ClouD-161803/TurboCAD_CourseWorkModule/Notes/Turbo CAD Part3A TT24.pdf

SW24 NOTES

BDF_TT23 SW2024NOTES

Turbomachinery CAD CWM PART 3A

RADIAL FLOW WATER TURBINE

Exercise 2 - Design, Manufacture and Testing of a Runner for Given Operating Point Conditions

Runner Performance

This part of the exercise is concerned with the testing of the runner over a range of flow rates through the turbine. Here, a series of measurements will be taken for varied settings of applied load at a target head and guide vane opening. The performance will be assessed in terms of power efficiency η versus flow rate Q. If a successful design has been achieved, the resulting curve should peak at the design operating point condition Q. Note that 1 bar = 10kPa.

MEASURED QUANTITIES

H ....... FLUID ENERGY HEAD | (bar)
Q ....... FLUID FLOW RATE | (litres/sec)
N ....... RUNNER SPEED | (revs/min)
T ....... ALTERNATOR TORQUE | (Nm)

Power Out

Po = T x ω = T x N/60 x 2π = 0.10472 x T x N (W)

Power In

Pi = ρgQH = 1000 x 9.81 x Q x 10⁻³ x H x 10.19

= 100 x Q x H (W)

Efficiency | η = Po/Pi

SW24 NOTES

BDF_TT23 SW2024NOTES

NAME: | COLLEGE: | DATE:
DESIGN ANGLES: | β1 = | β2 =

OPERATING POINT:

H = 0.7 bar | Q = 2.0 l/s | N = 1300 rpm | αo = 9.8°

Θo = Guide Vane Indicator Angle ≈ 63%

Use Matlab to Plot efficiency η against volumetric flow Q for the points recorded, along with a best fit curve. Note the value of Q for maximum η. Include a title, a grid, and axes labels and units.
Include the graph and suitable comments in your report.
(Q)η max = | (η)max = _____________
