ClouD-161803/TurboCAD_CourseWorkModule/CAD/Final Assembly/TC000.SLDASM

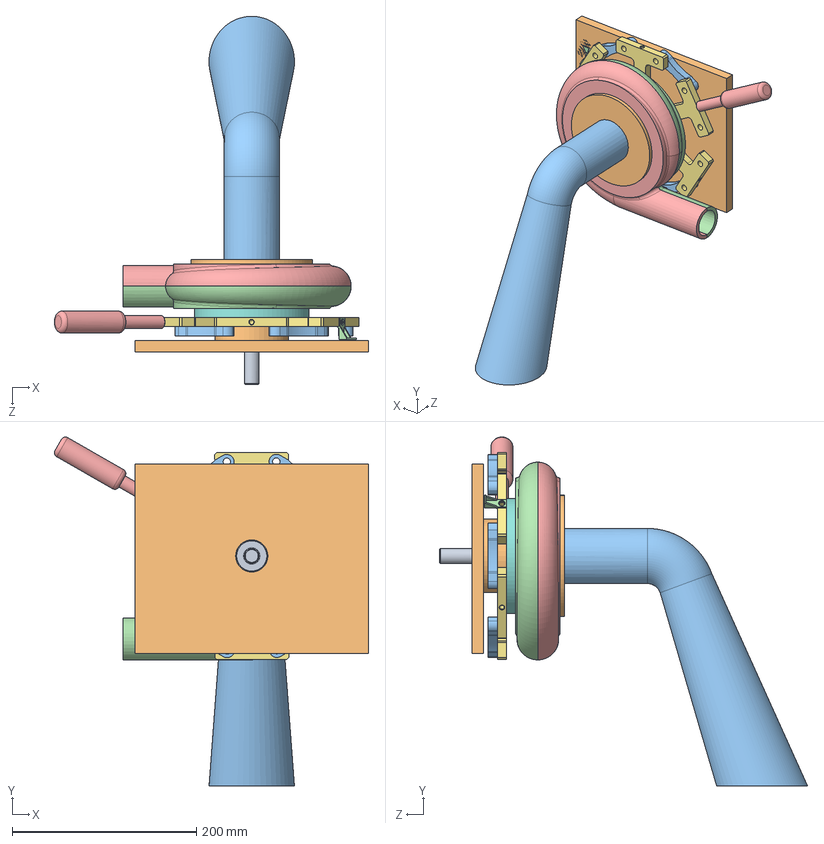
[picture p87: CAD file, 2024-10-17]
CAD/Final Assembly/TC000.SLDASM
341.5 x 379.3 x 400.3 mm
VC001
VC002
DT002
SP001
Runner_107.6
GV006
GV001 x 6
GV005 x 6
GV002
GV004
modified link x 5
MP001
DS001
