ClouD-161803/TurboCAD_CourseWorkModule/CAD/Francis Turbine/Modified assembly/GV000 no links.SLDASM

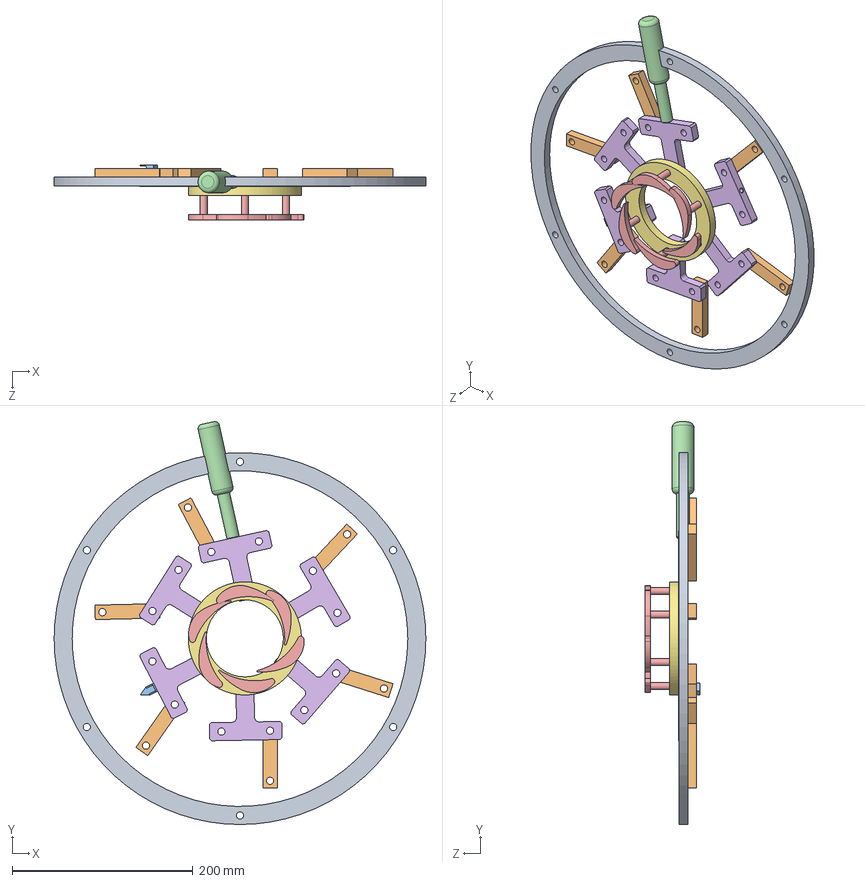
[picture p88: CAD file, 2024-10-17]
CAD/Francis Turbine/Modified assembly/GV000 no links.SLDASM
410.8 x 445.3 x 61.3 mm
GV006
GV001 x 6
GV005 x 6
GV002
GV004
GV003 x 6
gigaring
