ClouD-161803/TurboCAD_CourseWorkModule/CAD/Francis Turbine/Modified assembly/GV000.SLDASM

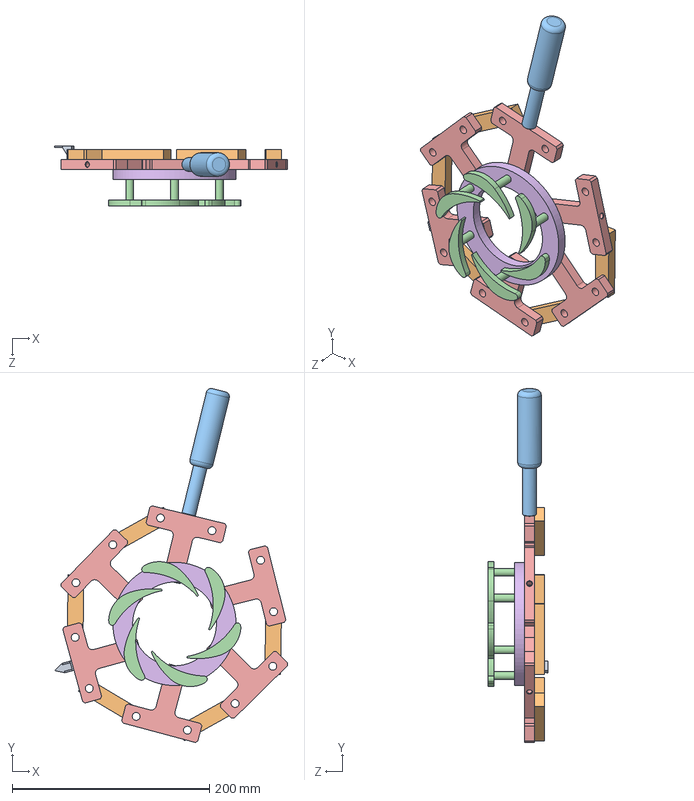
[picture p89: CAD file, 2024-10-17]
CAD/Francis Turbine/Modified assembly/GV000.SLDASM
236.5 x 359.2 x 61.3 mm
GV006
GV001 x 6
GV005 x 6
GV002
GV003 x 5
GV004
