ClouD-161803/TurboCAD_CourseWorkModule/CAD/Francis Turbine/Easy approach/Assembly/GV Sub Assembly.SLDASM

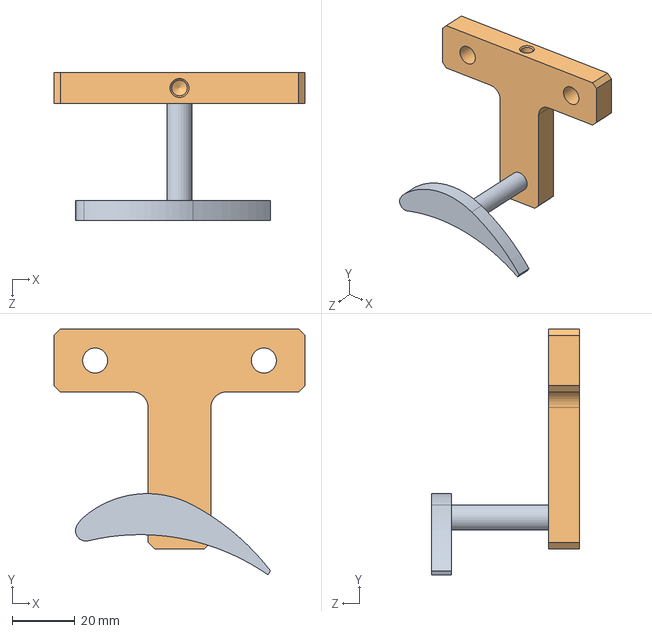
[picture p90: CAD file, 2024-10-17]
CAD/Francis Turbine/Easy approach/Assembly/GV Sub Assembly.SLDASM
80.0 x 78.3 x 47.3 mm
GV001
GV005
