ClouD-161803/TurboCAD_CourseWorkModule/CAD/Francis Turbine/Easy approach/Assembly/GV000 Final.SLDASM

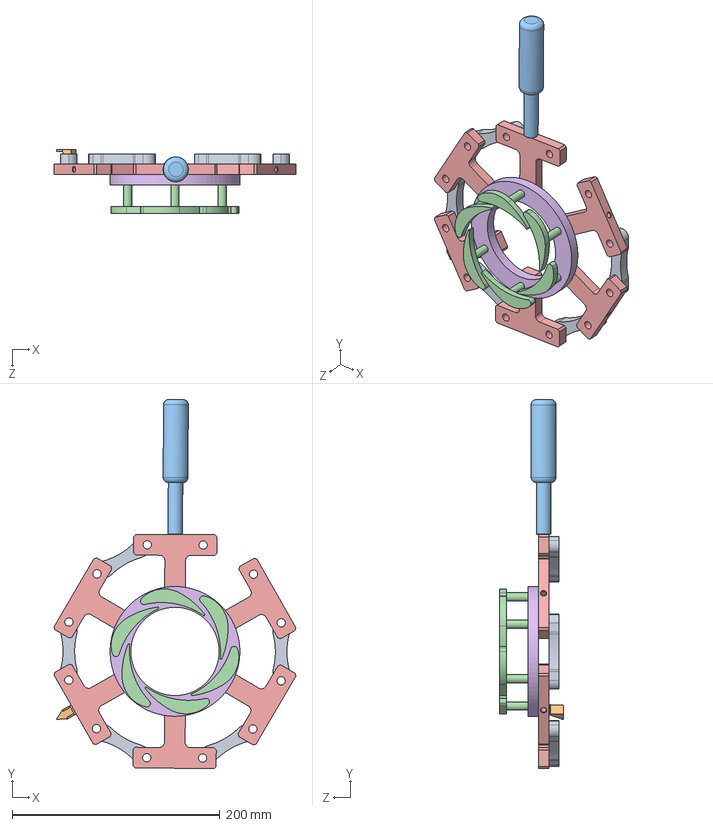
[picture p91: CAD file, 2024-10-17]
CAD/Francis Turbine/Easy approach/Assembly/GV000 Final.SLDASM
232.9 x 355.3 x 61.3 mm
GV006
GV001 x 6
GV005 x 6
GV002
GV004
modified link x 5
