ClouD-161803/TurboCAD_CourseWorkModule/CAD/Francis Turbine/Default  Assembly/GV000.SLDASM

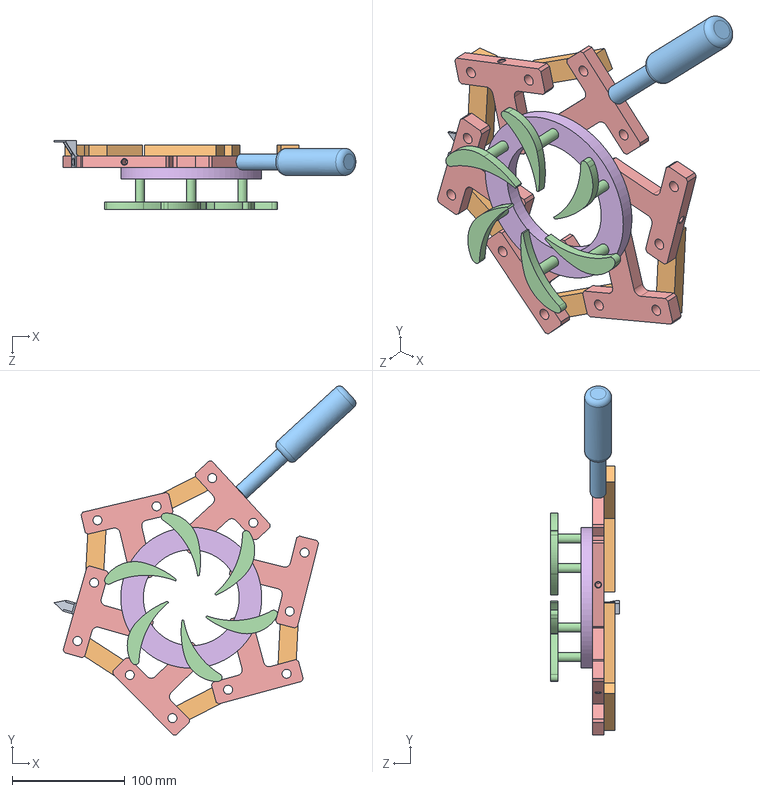
[picture p92: CAD file, 2024-10-17]
CAD/Francis Turbine/Default Assembly/GV000.SLDASM
267.6 x 309.5 x 61.3 mm
GV006
GV001 x 6
GV005 x 6
GV002
GV003 x 5
GV004
