ClouD-161803/TurboCAD_CourseWorkModule/CAD/Francis Turbine/Default  Assembly/GV001.SLDPRT

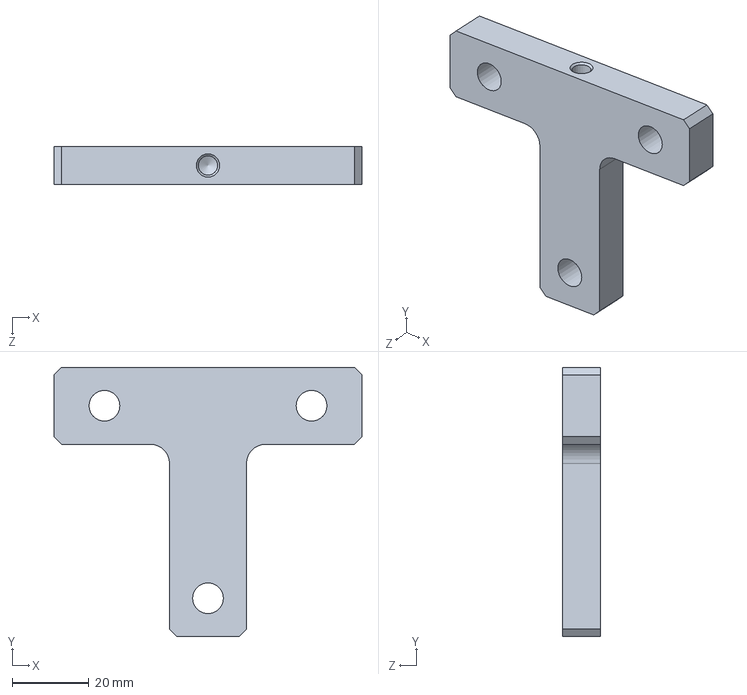
[picture p93: CAD file, 2024-10-17]
CAD/Francis Turbine/Default Assembly/GV001.SLDPRT
80.0 x 70.0 x 10.0 mm
