ClouD-161803/TurboCAD_CourseWorkModule/CAD/Francis Turbine/Easy approach/Assembly/GV002.SLDPRT

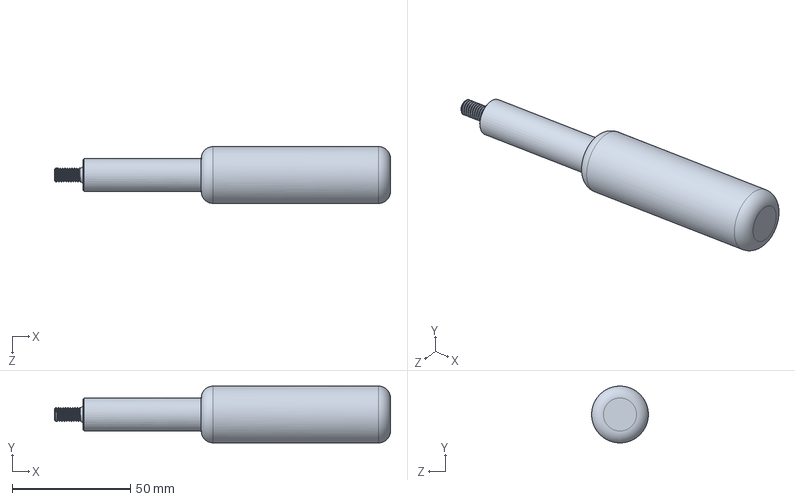
[picture p94: CAD file, 2024-10-17]
CAD/Francis Turbine/Easy approach/Assembly/GV002.SLDPRT
142.0 x 24.0 x 24.0 mm
