ClouD-161803/TurboCAD_CourseWorkModule/CAD/Impeller/Final/MP001.SLDPRT

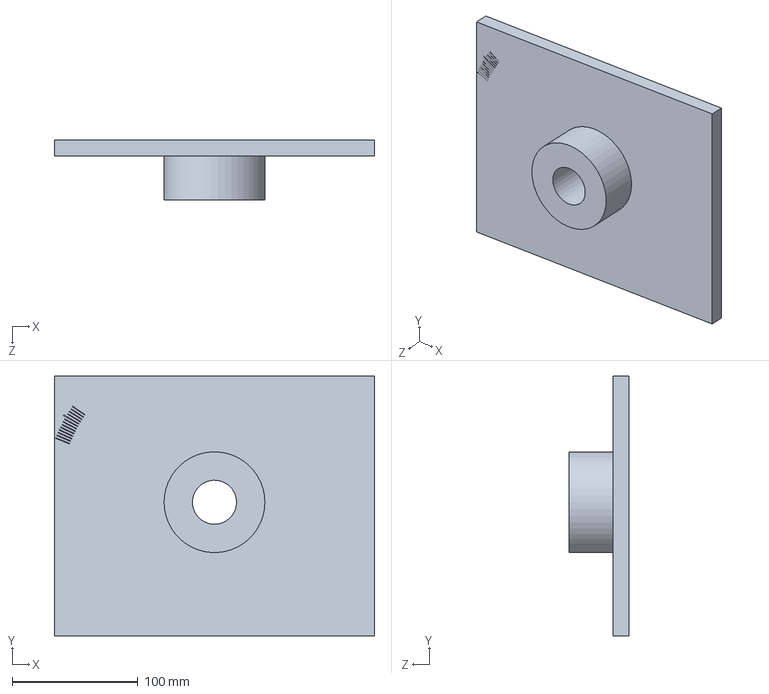
[picture p95: CAD file, 2024-10-17]
CAD/Impeller/Final/MP001.SLDPRT
254.0 x 206.0 x 47.7 mm
