ClouD-161803/TurboCAD_CourseWorkModule/CAD/Impeller/VC001 Wrong.SLDPRT

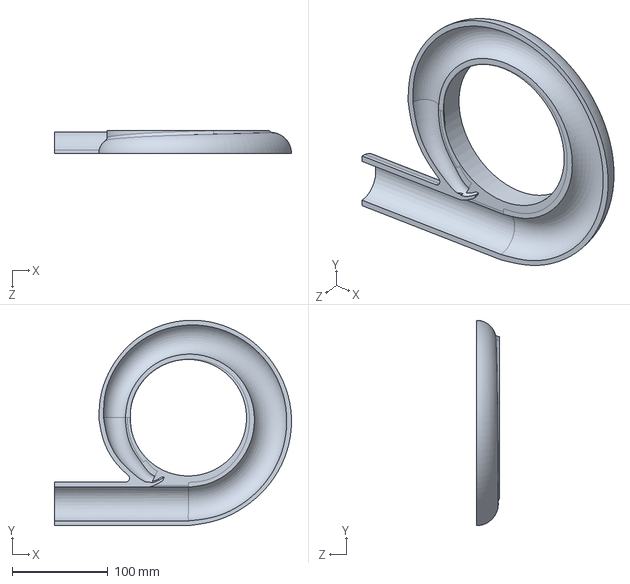
[picture p96: CAD file, 2024-10-17]
CAD/Impeller/VC001 Wrong.SLDPRT
248.0 x 214.9 x 24.0 mm
