ClouD-161803/TurboCAD_CourseWorkModule/CAD/Francis Turbine/Default  Assembly/GV004.SLDPRT

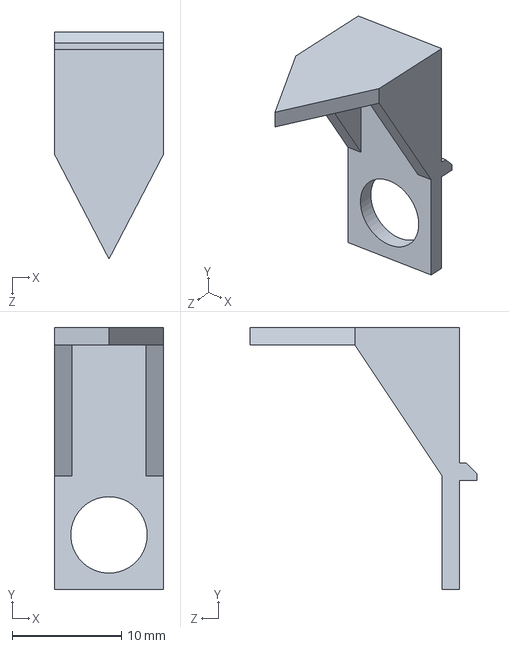
[picture p97: CAD file, 2024-10-17]
CAD/Francis Turbine/Default Assembly/GV004.SLDPRT
10.0 x 24.0 x 20.8 mm
