ClouD-161803/TurboCAD_CourseWorkModule/CAD/Francis Turbine/Easy approach/Assembly/GV003.SLDPRT

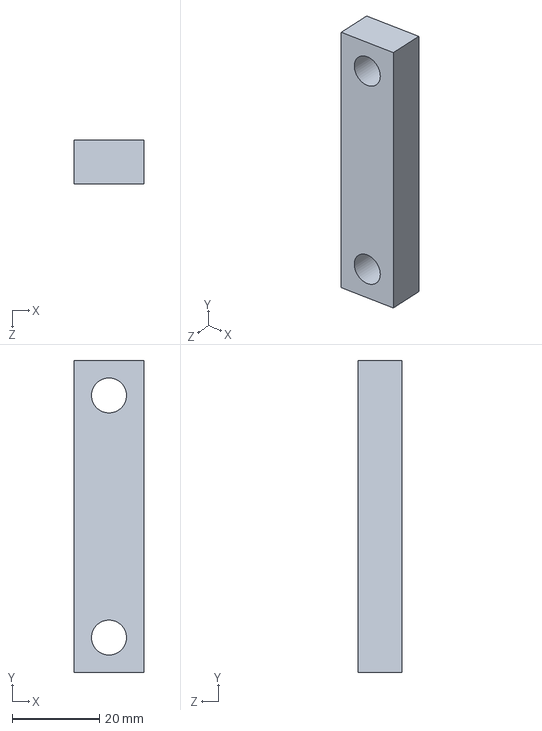
[picture p98: CAD file, 2024-10-17]
CAD/Francis Turbine/Easy approach/Assembly/GV003.SLDPRT
16.0 x 71.4 x 10.0 mm
