ClouD-161803/TurboCAD_CourseWorkModule/CAD/Francis Turbine/Modified assembly/gigaring.SLDPRT

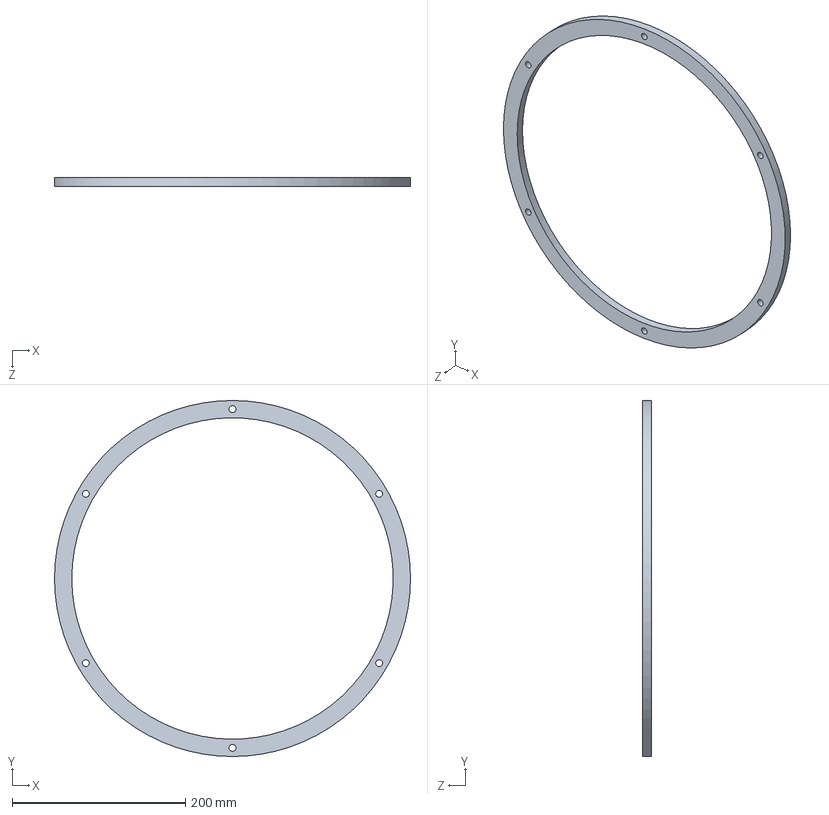
[picture p99: CAD file, 2024-10-17]
CAD/Francis Turbine/Modified assembly/gigaring.SLDPRT
410.8 x 410.8 x 10.0 mm
