ClouD-161803/TurboCAD_CourseWorkModule/CAD/Impeller/Final/SP001.SLDPRT

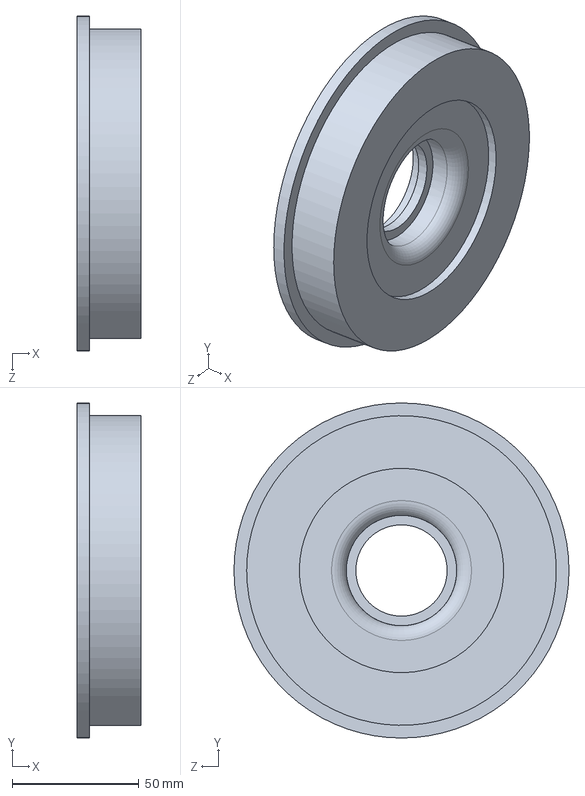
[picture p100: CAD file, 2024-10-17]
CAD/Impeller/Final/SP001.SLDPRT
25.3 x 132.0 x 132.0 mm
