ClouD-161803/TurboCAD_CourseWorkModule/CAD/Francis Turbine/Easy approach/Assembly/modified link.SLDPRT

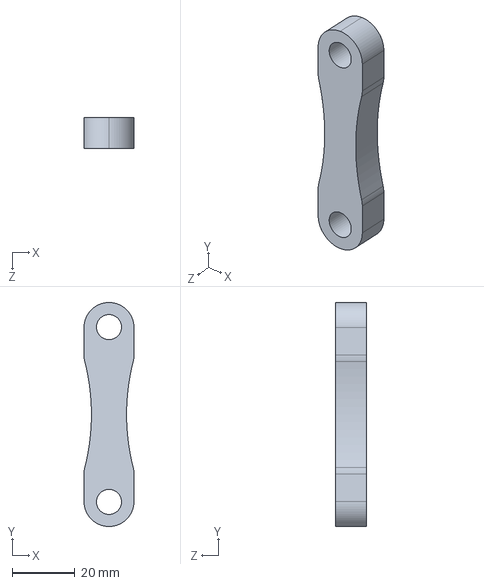
[picture p101: CAD file, 2024-10-17]
CAD/Francis Turbine/Easy approach/Assembly/modified link.SLDPRT
16.0 x 71.6 x 10.0 mm
