ClouD-161803/TurboCAD_CourseWorkModule/CAD/Impeller/Final/DS001.SLDPRT

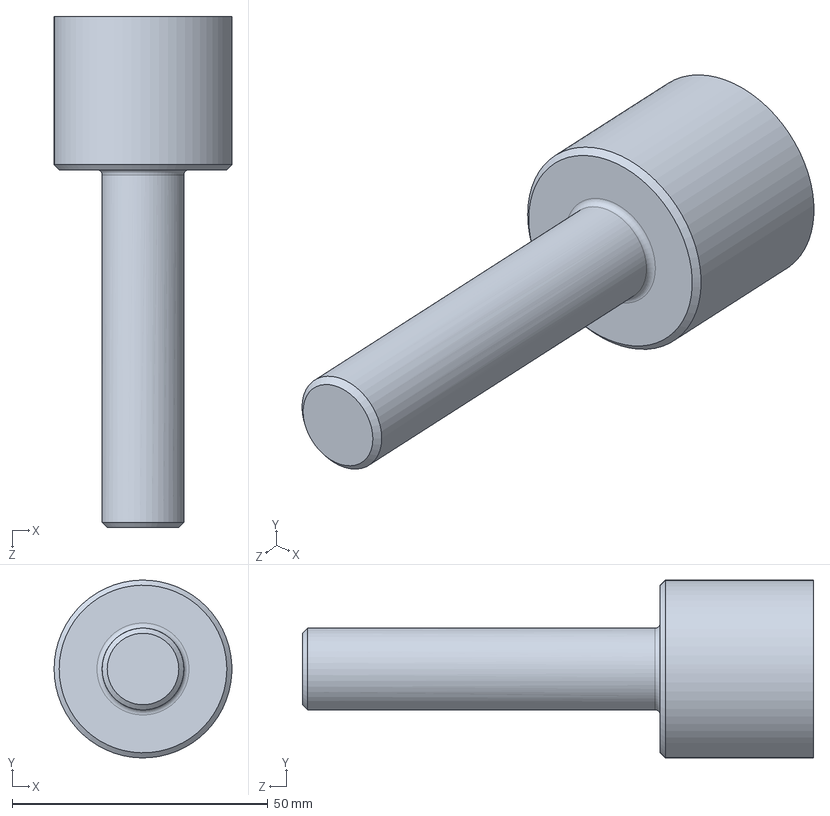
[picture p102: CAD file, 2024-10-17]
CAD/Impeller/Final/DS001.SLDPRT
34.8 x 34.8 x 100.0 mm
