ClouD-161803/TurboCAD_CourseWorkModule/CAD/Francis Turbine/Modified assembly/large ring.SLDPRT

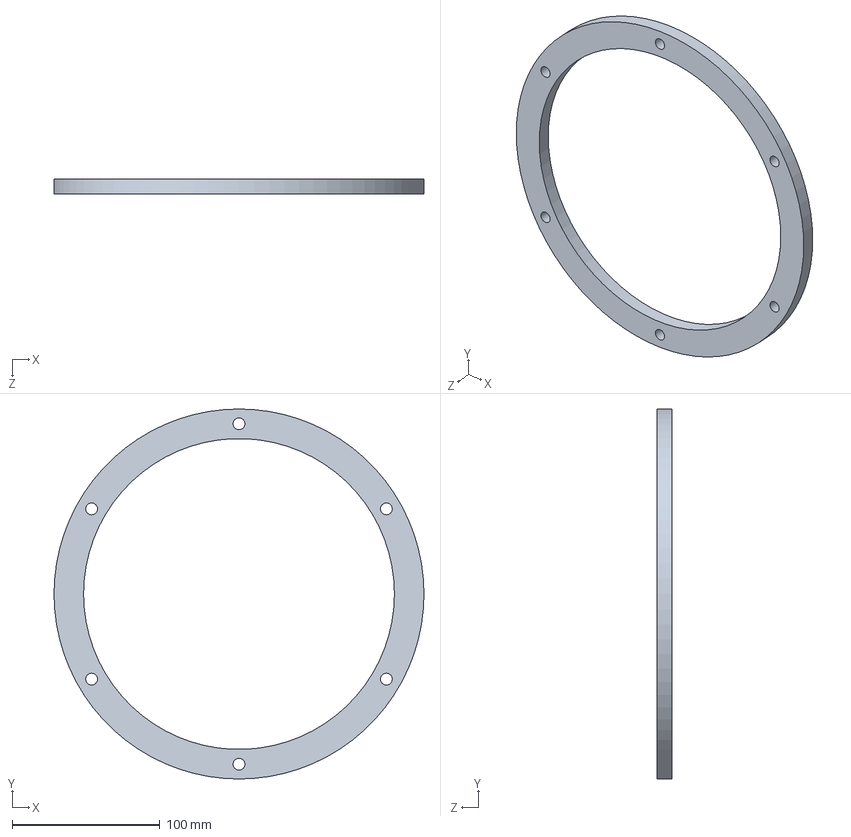
[picture p103: CAD file, 2024-10-17]
CAD/Francis Turbine/Modified assembly/large ring.SLDPRT
250.0 x 250.0 x 10.0 mm
