ClouD-161803/TurboCAD_CourseWorkModule/CAD/Francis Turbine/Easy approach/Assembly/GV006.SLDPRT

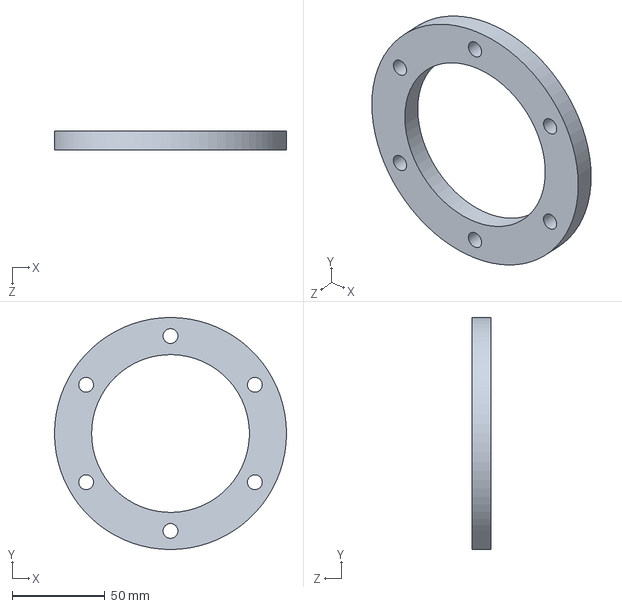
[picture p104: CAD file, 2024-10-17]
CAD/Francis Turbine/Easy approach/Assembly/GV006.SLDPRT
125.0 x 125.0 x 10.0 mm
