ClouD-161803/TurboCAD_CourseWorkModule/CAD/Impeller/Final/Runner_107.6.SLDPRT

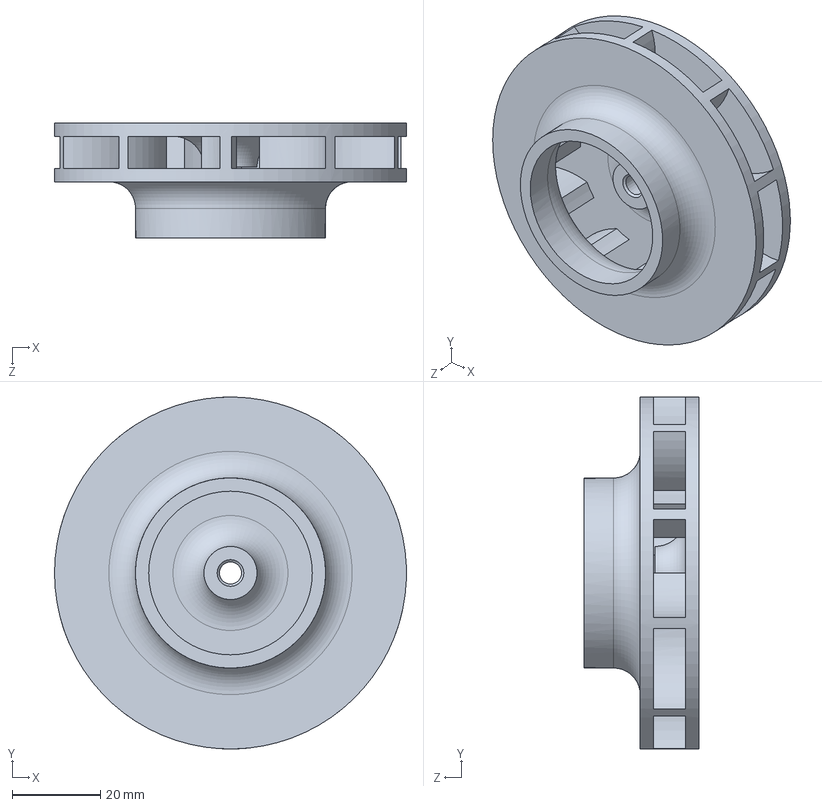
[picture p105: CAD file, 2024-10-17]
CAD/Impeller/Final/Runner_107.6.SLDPRT
79.6 x 79.6 x 26.0 mm
