ClouD-161803/TurboCAD_CourseWorkModule/CAD/Francis Turbine/Default  Assembly/GV005.SLDPRT

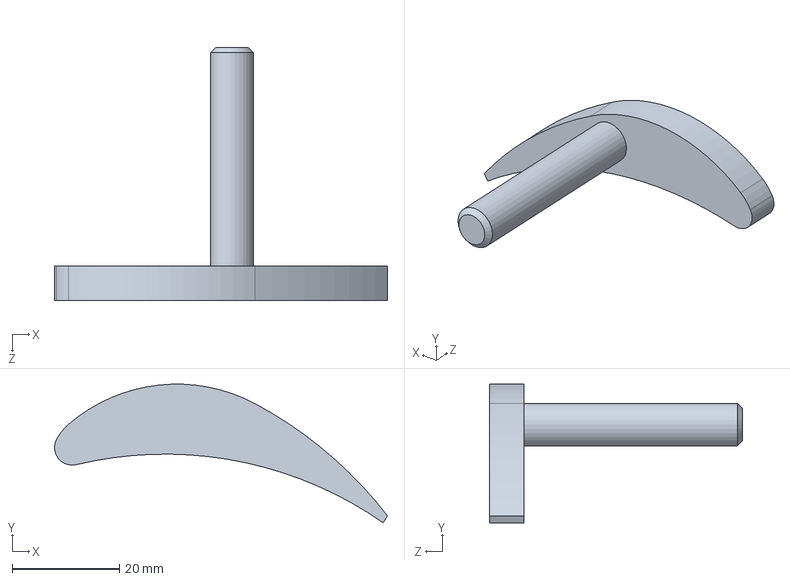
[picture p106: CAD file, 2024-10-17]
CAD/Francis Turbine/Default Assembly/GV005.SLDPRT
62.2 x 25.9 x 47.3 mm
