ClouD-161803/TurboCAD_CourseWorkModule/CAD/Impeller/Final/DT002.SLDPRT

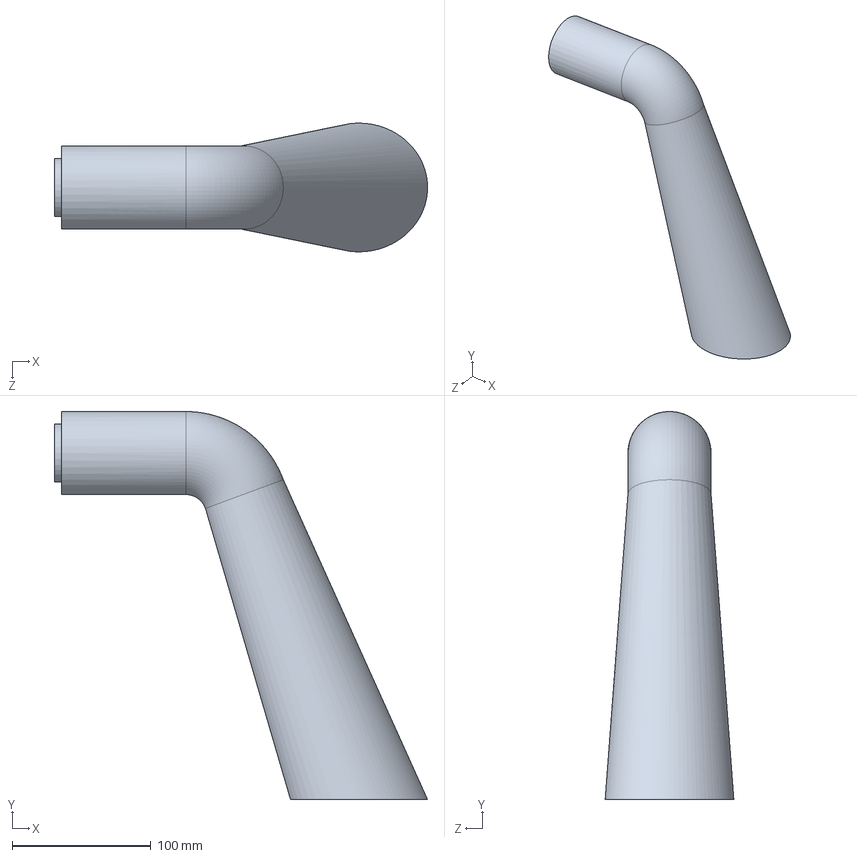
[picture p107: CAD file, 2024-10-17]
CAD/Impeller/Final/DT002.SLDPRT
269.3 x 280.0 x 92.9 mm
