ClouD-161803/TurboCAD_CourseWorkModule/CAD/Impeller/Final/VC002.SLDPRT

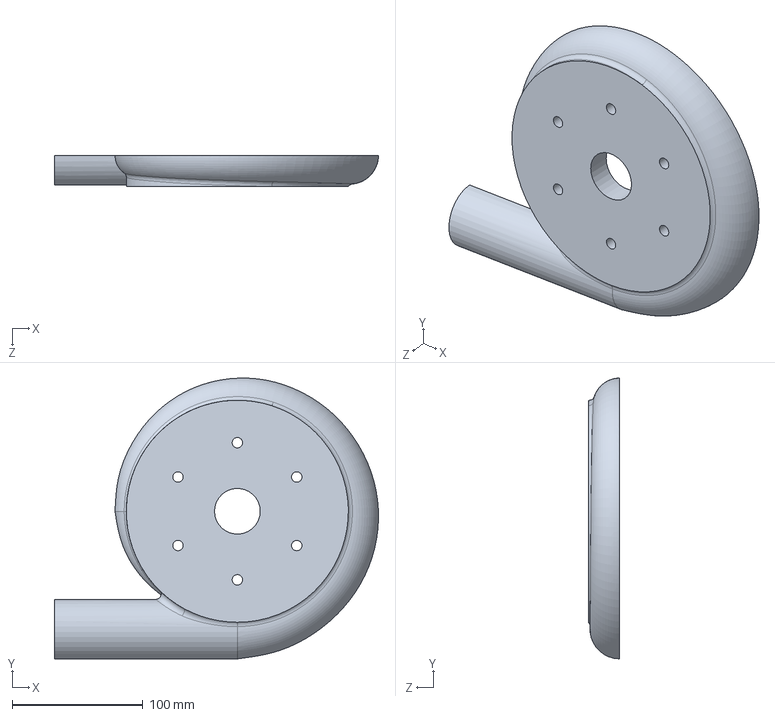
[picture p108: CAD file, 2024-10-17]
CAD/Impeller/Final/VC002.SLDPRT
248.0 x 214.9 x 24.0 mm
