ClouD-161803/TurboCAD_CourseWorkModule/(list of files, cad)

Other CAD files:
CAD/Impeller/Final/VC001.SLDPRT
CAD/Final Assembly/Turbine Assembly.SLDDRW
CAD/Francis Turbine/Easy approach/Results/GV000 Final.SLDDRW
CAD/Francis Turbine/Easy approach/Results/Modified Vane Link.SLDDRW
