ClouD-161803/TurboCAD_CourseWorkModule/Results/Material/Turbine Assembly Drawing.JPG

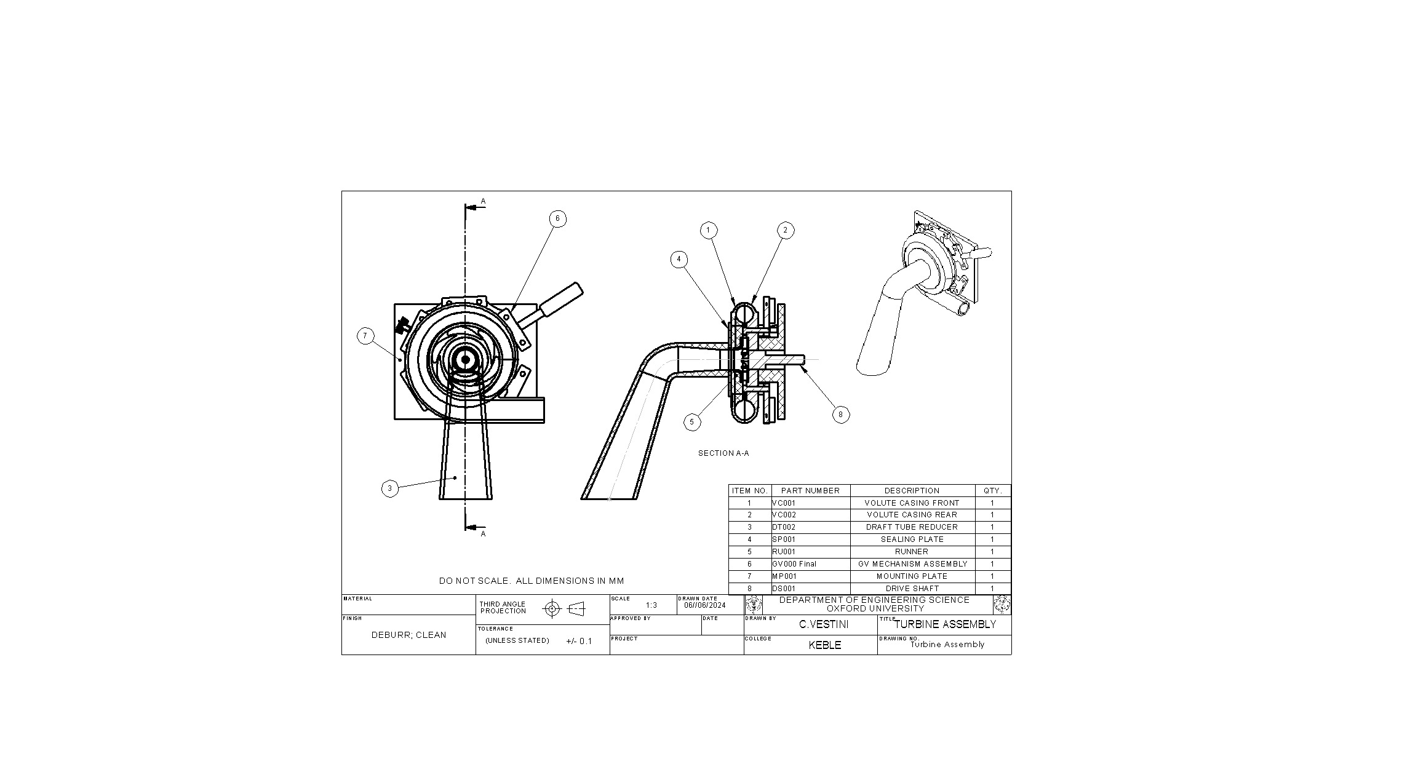
Results/Material/Turbine Assembly Drawing.JPG
