ClouD-161803/TurboCAD_CourseWorkModule/CAD/Francis Turbine/Easy approach/Results/Standard Link.csv

Vane End Points
Time (sec) | Linear Displacement1 (mm) | Linear Displacement2 (mm)
0 | 39.9208081376944 | 38.7980809827596
0.04 | 39.922194263288 | 38.7994263690389
0.08 | 39.9263229215197 | 38.8034337592973
0.12 | 39.9331495498113 | 38.8100601255568
0.16 | 39.9426296046804 | 38.8192625985739
0.2 | 39.9547185600511 | 38.8309984581636
0.24 | 39.9693719054022 | 38.8452251234629
0.28 | 39.9865451437799 | 38.8619001431899
0.32 | 40.0061937896994 | 38.8809811859219
0.36 | 40.0282733669612 | 38.9024260304149
0.4 | 40.0527394064036 | 38.9261925559904
0.44 | 40.0795474436144 | 38.9522387330118
0.48 | 40.1086530166223 | 38.9805226134691
0.52 | 40.1400116635873 | 39.0110023216966
0.56 | 40.1735789205093 | 39.0436360452377
0.6 | 40.2093103189712 | 39.0783820258788
0.64 | 40.2471613839334 | 39.1151985508653
0.68 | 40.2870876315947 | 39.1540439443183
0.72 | 40.3290445673321 | 39.1948765588639
0.76 | 40.372987683734 | 39.237654767489
0.8 | 40.4188724587368 | 39.2823369556358
0.84 | 40.466654353876 | 39.3288815135458
0.88 | 40.5162888126603 | 39.3772468288619
0.92 | 40.567731259078 | 39.4273912794994
0.96 | 40.6209370962415 | 39.4792732267908
1 | 40.6758617051773 | 39.5328510089131
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
