ClouD-161803/TurboCAD_CourseWorkModule/Results/Material/Test_Run_Francis_Calc_Group1.xlsx

Venturi Geometry |  |  |  | Water/Atmospheric Properties
A1 = | 0.0009079202769 | m2 |  | rho = | 1000 | kg/m3
A2 = | 0.0003141592654 | m2 |  | g = | 9.81 | m/s2
Cd = | 0.97 | - |  | Patm = | 1.01325 | bar
Column1 | Column2 | Column3 | Column4 | Column5 | Column6 | Column7 | Column8 | Column9 | Column10
Measure
Δp1 (bar) | 0.27 | 0.23 | 0.19 | 0.12 | 0.09 | 0.14 | 0.22 | 0.26 | 0.27
p2 (bar) | 0.71 | 0.81 | 0.93 | 1.15 | 1.25 | 1.06 | 0.84 | 0.74 | 0.72
T (Nm) | 0.56 | 0.57 | 0.57 | 0.45 | 0.35 | 0.51 | 0.57 | 0.55 | 0.55
N (RPM) | 1479 | 1506 | 1503 | 1506 | 1509 | 1495 | 1504 | 1498 | 1505
W_ts (W) | 87 | 89 | 89 | 70 | 54 | 79 | 89 | 87 | 86
GV % | 100 | 80 | 60 | 40 | 30 | 50 | 70 | 90 | 100
Q_v(m^3/s) | 0.00238677031 | 0.002202889246 | 0.002002191186 | 0.001591180207 | 0.001378002481 | 0.001718671054 | 0.002154468185 | 0.002342153847 | 0.00238677031
W_th (W) | 411.3001937 | 401.6417818 | 389.0758023 | 344.2120582 | 311.8764115 | 356.3234763 | 399.2768163 | 410.6381232 | 413.686964
n_t | 21.15243351 | 22.15904919 | 22.87471991 | 20.33630093 | 17.31455089 | 22.17086587 | 22.29029995 | 21.18653751 | 20.7886657
Flow Rate | Efficiency
0.08138668447 | 48.04708532
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
