ClouD-161803/TurboCAD_CourseWorkModule/Results/Material/Turbine Assembly Drawing.pdf

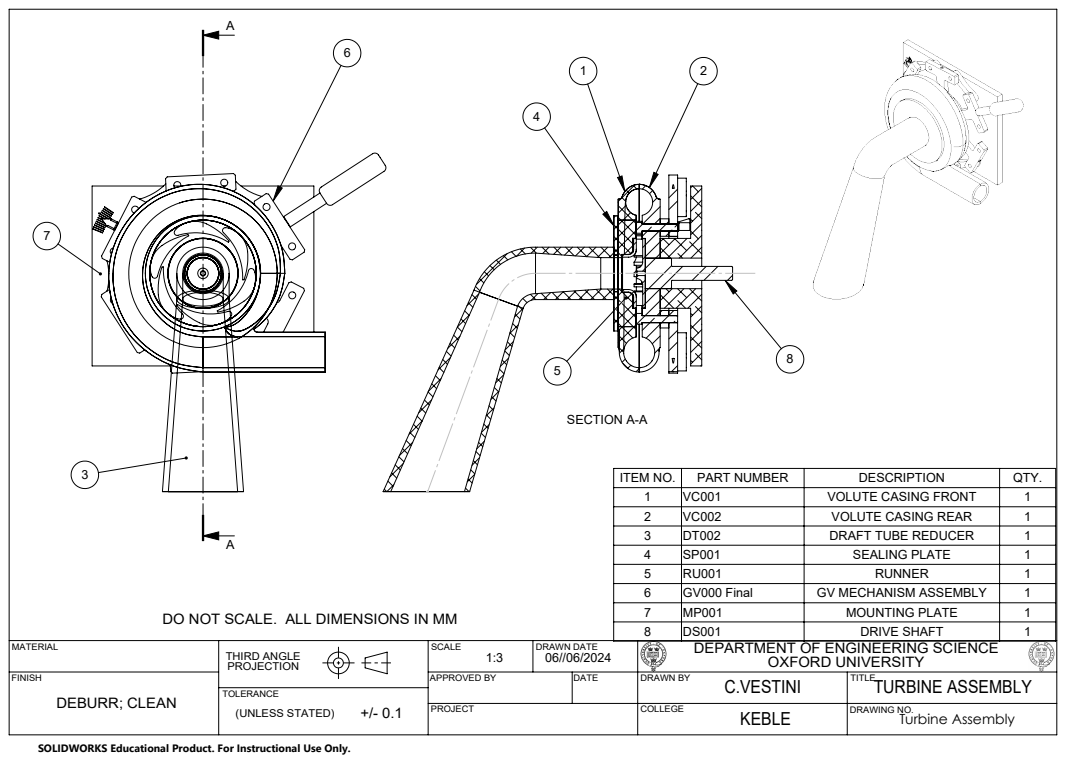
[picture p110: page 1]
SECTION A-A; TURBINE ASSEMBLY; OXFORD UNIVERSITY; DRAWING NO.; (UNLESS STATED); Turbine Assembly; DRAWN BY; DEBURR; CLEAN; APPROVED BY; DRAWN DATE; THIRD ANGLE

ITEM NO. | PART NUMBER | DESCRIPTION | QTY.
1 | VC001 | VOLUTE CASING FRONT | 1
2 | VC002 | VOLUTE CASING REAR | 1
3 | DT002 | DRAFT TUBE REDUCER | 1
4 | SP001 | SEALING PLATE | 1
5 | RU001 | RUNNER | 1
6 | GV000 Final | GV MECHANISM ASSEMBLY | 1
7 | MP001 | MOUNTING PLATE | 1
8 | DS001 | DRIVE SHAFT | 1

DO NOT SCALE. ALL DIMENSIONS IN MM

DEPARTMENT OF ENGINEERING SCIENCE
C.VESTINI
KEBLE

SOLIDWORKS Educational Product. For Instructional Use Only.
