ClouD-161803/TurboCAD_CourseWorkModule/Results/Material/Guide Vane Assembly Drawing.PDF

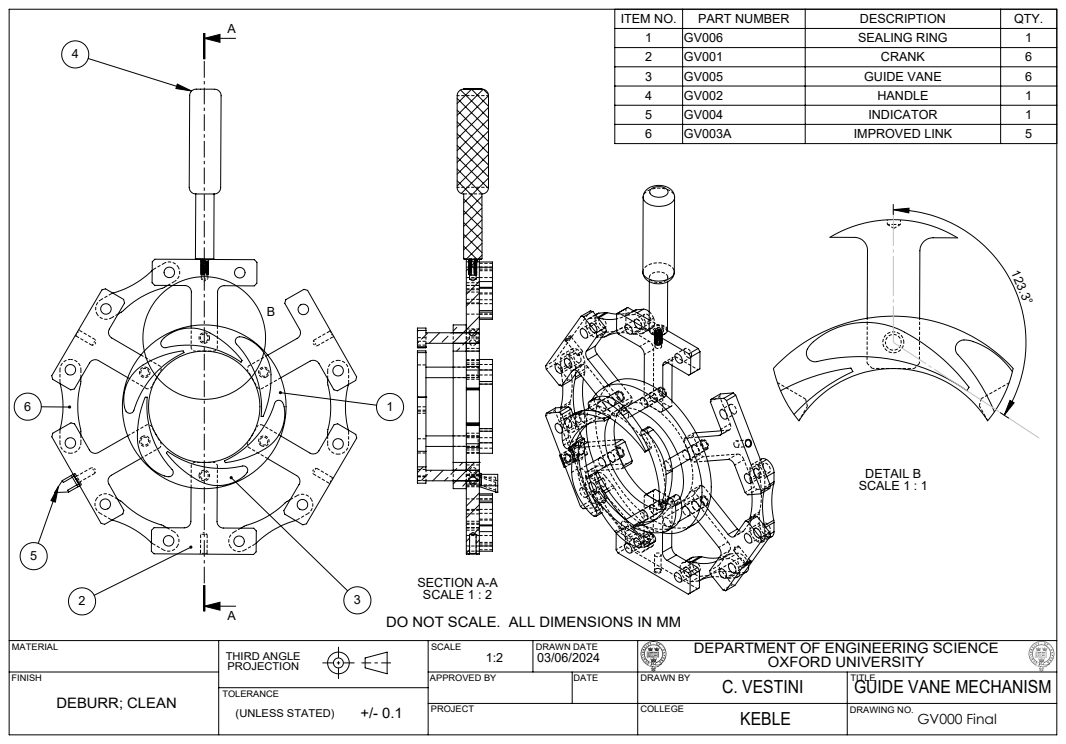
[picture p111: page 1]
DETAIL B SCALE 1 : 1; OXFORD UNIVERSITY; DRAWING NO.; (UNLESS STATED); GV000 Final; DRAWN BY; DEBURR; CLEAN; APPROVED BY; DRAWN DATE; THIRD ANGLE

ITEM NO. | PART NUMBER | DESCRIPTION | QTY.
1 | GV006 | SEALING RING | 1
2 | GV001 | CRANK | 6
3 | GV005 | GUIDE VANE | 6
4 | GV002 | HANDLE | 1
5 | GV004 | INDICATOR | 1
6 | GV003A | IMPROVED LINK | 5

SECTION A-A
SCALE 1 : 2
DO NOT SCALE. ALL DIMENSIONS IN MM

DEPARTMENT OF ENGINEERING SCIENCE
C. VESTINI
KEBLE

TITLE
GUIDE VANE MECHANISM
