ClouD-161803/TurboCAD_CourseWorkModule/Results/Material/Modified Vane Link Drawing.pdf

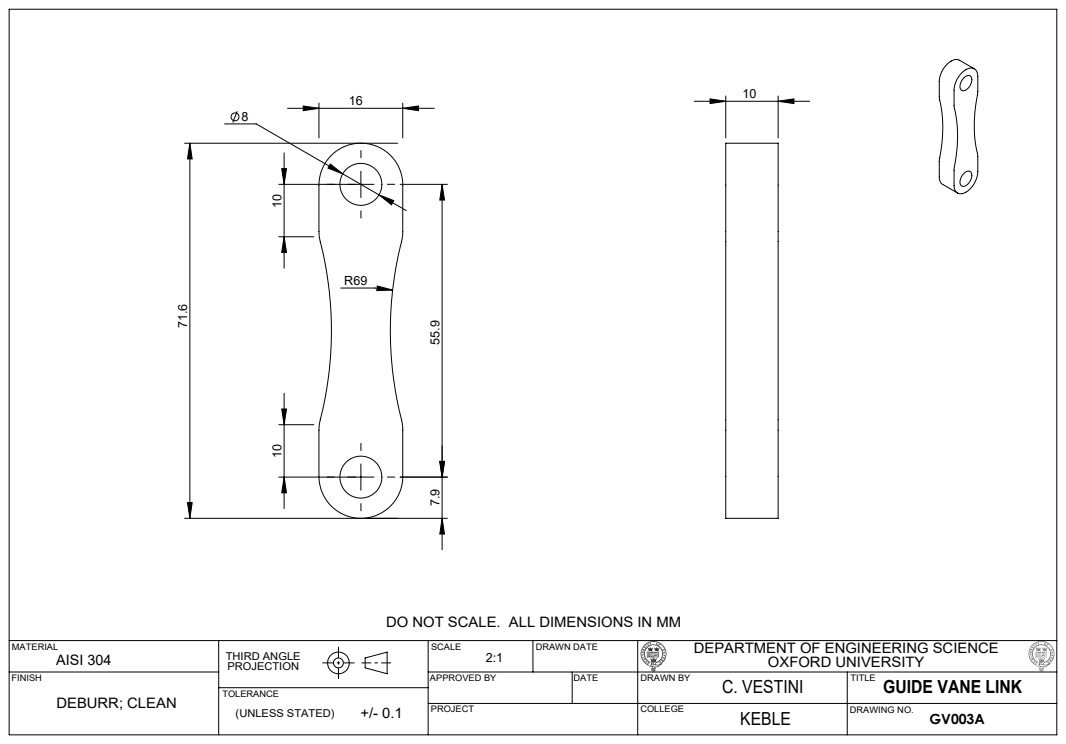
[picture p112: page 1]
GUIDE VANE LINK; OXFORD UNIVERSITY; DRAWING NO.; (UNLESS STATED); DRAWN BY; DEBURR; CLEAN; APPROVED BY; DRAWN DATE; THIRD ANGLE; AISI 304

DO NOT SCALE. ALL DIMENSIONS IN MM

DEPARTMENT OF ENGINEERING SCIENCE
C. VESTINI
KEBLE
